JustinPringle/TWLogger/README.md

# TWLogger
## Arduino inertial movement data logger
- Version 2 (IMU)
- Version 3 (IMU+GPS)
