JustinPringle/TWLogger/DataProcessing/Sample_Data/README.md

# TWLogger Sample Data

- Calibration_Data
	- Tag1_LSM303cal.csv - Pre-pocessed Calibration Values (derived from the Raw_data in the accompanying folder)
	- Raw_Calibration_Data - These files can be used to create a Cal file (e.g. Tag1_LSM303cal.csv)
- Raw_Data
	- T1S0708-00.TXT - Deployment details
	- T1D0708-00.CSV, T1D0708-01.CSV - Raw deployment data for use in Data Processing Scripts
