JustinPringle/TWLogger/TWLogger V2/TWLoggerV2.4_LSM9DS0/BuildPhotos/FinalTopView.jpg

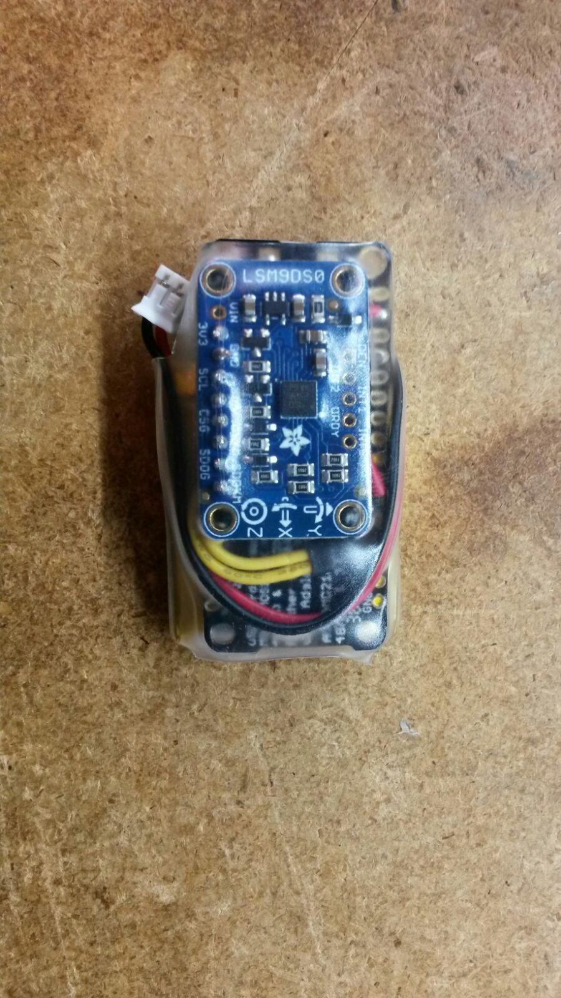
TWLogger V2/TWLoggerV2.4_LSM9DS0/BuildPhotos/FinalTopView.jpg
