JustinPringle/TWLogger/TWLogger V2/TWLoggerV2.4_LSM9DS0/BuildPhotos/IMG-20170116-WA0032.jpg

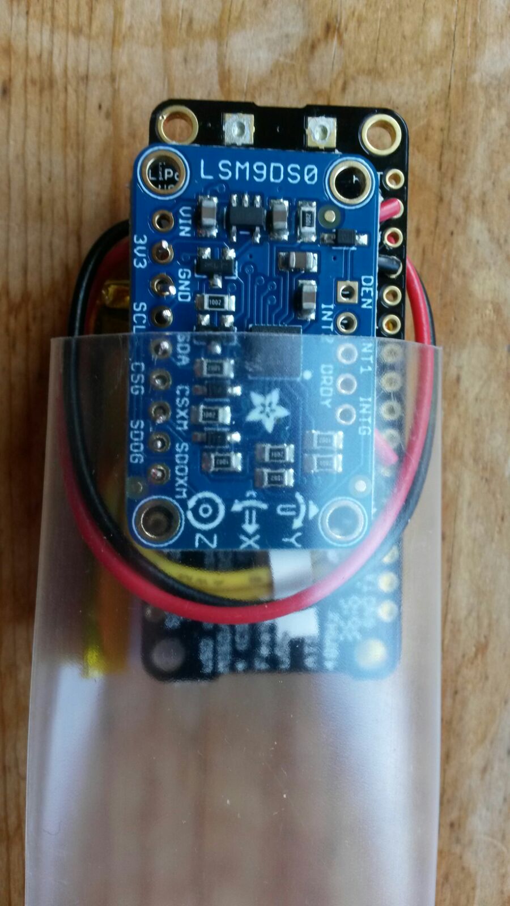
TWLogger V2/TWLoggerV2.4_LSM9DS0/BuildPhotos/IMG-20170116-WA0032.jpg
