JustinPringle/TWLogger/TWLogger V3 (GPS)/TWLogger v3.3_LSM303/TWLoggerV3.3_GPS_LSM303.ino

/*
 Author: James Fahlbusch
 
 Low Power Inertial Movement Datalogger for Feather M0 Adalogger 
 Version 3.3
 Samples Temp, Accel, Mag, and GPS
 Logs to CSV, flushing data after SamplesPerCycle samples
 Internal RTC used to timestamp sensor data
 Utilizes ReTick to Save Power (Sleeps during Idle time)
 Restarts logging if reset (time sync is lost)
 
 RED LED blinks once per minute for a low consumption pulse
 
 Connections (USES I2C and UART)
 Feather M0 to LSm303
 ===========
 Connect Pin 24 (SCL) to SCL
 Connect Pin 23 (SDA) to SDA
 Connect 3V to VIN
 Connect GND to GND
 Feather M0 to UltimateGPS
 ===========
 Connect Pin 12 to En (Enable Pin)
 Connect TX to RX
 Connect RX to TX
 Connect 3V to VIN
 Connect GND to GND
 Connect 3V to VBAT

 Version Notes:
 Added Logfile Timestamps 1/15/17
 Improved Serial Output 1/18/17
 Added clock sync and Sensor Standby 1/21/17
 Changed Acc ODR to 50HZ 1/25/17 
 Implemented ReTick to sleep during unutilized CPU time 1/27/17
 Added Serial Menus and Updated Alarm and Timing 1/29/17
 Added reset timeout for tag restart 11/3/17
 Added GPS functionality 6/4/18 
 Added GPS control Options 6/29/18
 Added Log Chip Serial and samplingRate Options 7/25/18
 Changed Flush and File creation to ensure more regular sampling 8/7/18
 Changed File Naming for 2 digit tag numbers 1/26/19
 Added Plotter Output 1/31/19
 Better GPS Error Checking 8/18/19
 Added functionality to change sensor settings (ODR, scale and gain) 10/8/19
 Added Acceleration and Magnetic field conversion to real units in plotter 4/8/20

 Power Consumption: 
 500mAh Battery - ~39hrs @ 5min GPS, ~32hrs @ 2min GPS, ~26hrs @ 1min (50Hz ACC/Mag)
*/

// ToDo~!!
// *** Add fix delay option (Much like a start delay but determined by gps fix) ***
// Sensitivity testing of variables like timeout, number of samples to collect, MS smart delay
// Retick running at 20ms is actually taking 20.xxx milliseconds, which results in a sample to be missed once every 20 seconds

//////////////// Key Settings /////////////////////////////////
#define vers "Version 3.3"
//#define ECHO_TO_SERIAL       // Allows serial output if uncommented
//#define ECHO_ACC_PLOTTER     // Serial output of just ACC for plotter display (plots in meters/second^2)
//#define ECHO_MAG_PLOTTER     // Serial output of just ACC for plotter display (plots in micro Teslas)
//#define GPSECHO              // Echo the GPS data to the Serial console
//#define Gyro_On              // Allows Gyro output if uncommented
#define MinutesPerCycle 1      // Number of Minutes to buffer before uSD card flush is called. 
#define HoursPerFile 5         // Number of Hours of data per file
#define retickRate 20          // Default sampling rate of 50Hz
#define Serial_Timeout  300000 // Wait time in menu before starting tag (5 min)
// GPS Settings
#define GPS_TIMEOUT         60 // Seconds to wait for a fix to be logged before sleeping
#define GPS_SAMPLING_RATE  120 // Seconds of GPS sleep between data acquisition
#define GPS_DELAY_READ       5 // Seconds to wait before trying to log - allows for a fix
#define LOOP_MAX_VAL         1 // Number of GPS reads before sleeping
#define SMART_DELAY_MS      10 // Number of milliseconds to spend encoding GPS data between other instructions

//////////////// Libraries //////////////////////
#include <RTCZero.h> 
#include <SdFat.h>
SdFat SD;
#include <Wire.h>
#include <SPI.h>
#include <TW_LSM303v2.h>       //library for Accel Mag Sensor LSM 303, updated
#include <TinyGPS.h>
//Libraries for ReTick
#include "Arduino.h"
#include "retick.h"

//////////////// GPS Seentences ///////////////////////////////
// GPS Setup Sentences
#define PMTK_SET_BAUD_9600 "$PMTK251,9600*17"
#define PMTK_SET_BAUD_57600 "$PMTK251,57600*2C"
#define PMTK_SET_NMEA_UPDATE_1HZ  "$PMTK220,1000*1F"
#define PMTK_API_SET_FIX_CTL_1HZ  "$PMTK300,1000,0,0,0,0*1C"
// turn on only the second sentence (GPRMC)
#define PMTK_SET_NMEA_OUTPUT_RMCONLY "$PMTK314,0,1,0,0,0,0,0,0,0,0,0,0,0,0,0,0,0,0,0*29"
// turn on GPRMC and GGA
#define PMTK_SET_NMEA_OUTPUT_RMCGGA "$PMTK314,0,1,0,1,0,0,0,0,0,0,0,0,0,0,0,0,0,0,0*28"
#define PGCMD_NOANTENNA "$PGCMD,33,0*6D" 

/////////////// Global Objects ////////////////////
#define GPSSerial Serial1
TinyGPS GPS;
bool gpsStandby = false;
unsigned int gpscount = 0;
bool endGPSRead = false;
bool logGPS = false; 
long gpsRate = GPS_SAMPLING_RATE; // Seconds of GPS sleep between data acquisition
long gpsTimeOut = GPS_TIMEOUT;    // Seconds to wait for a fix to be logged before sleeping
long gpsDelay = GPS_DELAY_READ;   // Seconds to wait before trying to log - allows for a fix
long loopMaxGPS = LOOP_MAX_VAL;             // Number of GPS reads before sleeping
long smartDelayMS = SMART_DELAY_MS;// Number of milliseconds to spend encoding GPS data between other instructions
unsigned int  loopCounter  = 0;             // Loop counter
unsigned int readCount = 0;
unsigned int hzGPSLog = 0;
char          inByte       = 0;             // Incoming serial byte
String        reading      = "";            // String to hold current reading being created
//Intialize GPS variables
unsigned short sentences = 0, failed = 0;
long lat, lon, altitude;
unsigned long fixage, age, dateUTC, timeUTC, chars = 0;
unsigned long course, speed, sats, hdop;

TW_LSM303v2 lsm = TW_LSM303v2(); // Initialize the IMU
// Default sampling rates
byte AccODR = 0x64;
byte AccRes = 0x08;
byte MagODR = 0x4B;
byte MagRes = 0x04;

#define cardSelect 4  // Set the pin used for uSD
#define RED 13        // Red LED on Pin #13
#define GREEN 8       // Green LED on Pin #8
#define VBATPIN A7    // Battery Voltage on Pin A7
#define gpsEnable 12  // GPS Enable Pin

// re-defines USB serial from M0 chip so it appears as regular serial
#if defined(ARDUINO_SAMD_ZERO) && defined(SERIAL_PORT_USBVIRTUAL)
  // Required for Serial on Zero based boards
  #define Serial SERIAL_PORT_USBVIRTUAL
#endif

char s_month[5];
int tmonth, tday, tyear, thour, tminute, tsecond; 
static const char month_names[] = "JanFebMarAprMayJunJulAugSepOctNovDec"; 

/* Change these values to set the current initial time */
byte hours = 0;
byte minutes = 0;
byte seconds = 0;
/* Change these values to set the current initial date */
byte day = 1;
byte month = 1;
byte year = 17; 
uint32_t tmstmp = 0; // to store Milliseconds (from millis())    
//Used for a time delay, Sets arduino into standby for x minutes
//Could be a local variable instead of global
unsigned short delayStart = 0;
// Variable used to keep track of changes in seconds, minutes, hours, days, months
// Limits the number of calls to RTC
unsigned int timekeeper = 0;
// Variable to store the tag number
uint8_t tag = 0;
uint16_t samplingRate = retickRate; // set sampling rate to default (50Hz)

RTCZero rtc;          // Create RTC object
File logfile;         // Create file object
File settingsFile;    // Create file object
char filename[15];    // Array for file name data logged to named in setup 
char settingsFilename[15];    // Array for file name of Settings File to log settings of Deployment
unsigned int CurrentCycleCount;  // Num of smaples in current cycle, before uSD flush call
unsigned int CurrentFileCount;   // Num of samples in current file
bool start = false;
char tzOffset[] = "+00";    // Array to store Timezone Offset, stored in info file

///////// File Interaction Variables ///////////////////
const uint8_t spiSpeed = SPI_FULL_SPEED; // Use SPI_HALF_SPEED for slower SPI bus speed
// constants for file system structure
uint16_t const BU16 = 128;
uint16_t const BU32 = 8192;
#define sdError(msg) sdError_F(F(msg))
// Serial output stream
ArduinoOutStream cout(Serial);

Sd2Card card;
uint32_t cardSizeBlocks;
uint16_t cardCapacityMB;

// cache for SD block
cache_t cache;

// MBR information
uint8_t partType;
uint32_t relSector;
uint32_t partSize;

// Fake disk geometry
uint8_t numberOfHeads;
uint8_t sectorsPerTrack;

// FAT parameters
uint16_t reservedSectors;
uint8_t sectorsPerCluster;
uint32_t fatStart;
uint32_t fatSize;
uint32_t dataStart;

//  strings needed in file system structures
char noName[] = "NO NAME    ";
char fat16str[] = "FAT16   ";
char fat32str[] = "FAT32   ";
// flash erase all data
uint32_t const ERASE_SIZE = 262144L;


//////////////    Setup   ///////////////////
void setup() {  
  strcpy(filename, "D000101-00.CSV");   // Template for log file name, characters 2 & 3 (Tag#), 8 & 9 (LogFile#) get set automatically later
  strcpy(settingsFilename, "S000101-00.TXT");   // Template for settings file name, characters 2 & 3 (Tag#), 8 & 9  (SettingsFile#) will be used if other deployments are on the same card.
  //enable the GPS
  pinMode(gpsEnable, OUTPUT);
  digitalWrite(gpsEnable, HIGH);

  Serial.begin(115200);
  tmstmp = millis(); //to store a timeout value
  while (!Serial) { // Wait for Serial monitor to open
    if( millis() - tmstmp > Serial_Timeout ) {
       // timed out, restart tag using default values
       start = true;
       tmstmp = 0;
       break;  
    }
  }
  
  //This could be a part of the menu and could give the option to turn it on or leave it off
  GPSSerial.begin(9600); // For Tiny GPS
  GPSSerial.println(PMTK_SET_NMEA_OUTPUT_RMCGGA);
  delay(500);
  GPSSerial.println(PMTK_SET_NMEA_UPDATE_1HZ);
  delay(500);
  GPSSerial.println(PMTK_API_SET_FIX_CTL_1HZ);
  delay(500);

  GPSSerial.println(PMTK_SET_BAUD_57600);
  delay(500);
  GPSSerial.end();
  delay(500);
  GPSSerial.begin(57600);
  delay(500);
  GPSSerial.println(PGCMD_NOANTENNA); 
  delay(500);

  if(!start) {
    // This code sets the clock using serial time.
    // __DATE__ is a C++ preprocessor string with the current date in it.
    // It will look something like 'Mar  13  2016'.
    // So we need to pull those values out and convert the month string to a number.
    sscanf(__DATE__, "%s %d %d", s_month, &tday, &tyear);
    // Similarly, __TIME__ will look something like '09:34:17' so get those numbers.
    sscanf(__TIME__, "%d:%d:%d", &thour, &tminute, &tsecond);
    // Find the position of this month's string inside month_names, do a little
    // pointer subtraction arithmetic to get the offset, and divide the
    // result by 3 since the month names are 3 chars long.
    tmonth = (strstr(month_names, s_month) - month_names) / 3;
    month = tmonth + 1;  // The RTC library expects months to be 1 - 12.
    day = tday;
    year = tyear - 2000; // The RTC library expects years to be from 2000.
    hours = thour;
    minutes = tminute;
    seconds = tsecond;  
    // This is ~30 seconds off due to the time it takes to compile the
    // .ino file and upload the app
  }
  rtc.begin(); // initialize RTC
  rtc.setTime(hours, minutes, seconds);
  rtc.setDate(day, month, year);
  updateFileNames();
  
  /* Initialise the IMU with default settings */
  if(!lsm.begin())
  {
    /* There was a problem detecting the LSM9DS0 ... check your connections */
    Serial.print(F("Ooops, no LSM303 detected ... Check your wiring!"));
    while(1);
  }
  delay(500);

  /* Enter Menu (if serial monitor is open) */  
  while(!start){
    // Print the control menu:
    printMenu();
    // Then wait for any serial data to come in:
    while (!Serial.available());   
    // Once serial data is received, call parseMenu to act on it:
    parseMenu(Serial.read());   
  }

  //Set Alarm
  if(delayStart > 0) {
    
    Serial.println("Logging will begin at:");  
    print2digits(rtc.getAlarmHours());
    Serial.print(":");
    print2digits(rtc.getAlarmMinutes());
    Serial.print(":");
    print2digits(rtc.getAlarmSeconds());
    Serial.print(" on ");
    // Print date...
    print2digits(rtc.getAlarmMonth());
    Serial.print("/");
    print2digits(rtc.getAlarmDay());
    Serial.print("/");
    print2digits(rtc.getAlarmYear());
    Serial.println();
    Serial.println("It is now safe to unplug the unit");
    Serial.end();
    delay(1000);
    rtc.standbyMode();
    rtc.disableAlarm(); 
    rtc.detachInterrupt();
    rtc.updateAlarms();
    delay(5000);
  }
  else {
    Serial.println("Logging will begin immediately"); 
    Serial.println("It is now safe to unplug the unit");
    Serial.end();
  }
  delay(500);
  #ifdef ECHO_TO_SERIAL
    while (! Serial); // Wait until Serial is ready
    Serial.begin(115200);
    Serial.println("\r\nTapered Wings Logger");
  #endif
  #ifdef GPSECHO
    while (! Serial); // Wait until Serial is ready
    Serial.begin(115200);
    Serial.println("\r\nTapered Wings Logger");
  #endif
  delay(500);
  CreateSettingsFile();  
  //start with the current time
  updateTime();
  CreateFile(); 
  reading      = ""; // reset reading
}  

/////////////////////   Loop    //////////////////////
void loop() {
  /*  Each run-through of tick will be samplingRate (default 20ms or 50Hz)
   *  If it takes less than samplingRate, the CPU will sleep
   *  If it takes more, it immediately goes into next 
   *  tick once the previous finishes
   */
  retick(samplingRate);
}

/////////////////////   ReTick    //////////////////////
void tick() {
  WriteToSD();   // Output to uSD card stream, will not actually be written due to buffer/page size  
}

///////////////   Functions   //////////////////

// Create new file on uSD incrementing file name as required
//Purpose of the file is to capture sensor settings, sampling rate, associated log files and battery status
void CreateSettingsFile(void)
{  
  // see if the card is present and can be initialized:
  if (!SD.begin(cardSelect)) {
    #ifdef ECHO_TO_SERIAL
      Serial.println("Card init. failed! or Card not present");
    #endif
    error(2);     // Two red flashes means no card or card init failed.
  }
  //increments the value of the ## in filename (Max is 99)
  for (uint8_t i = 0; i < 100; i++) {
    settingsFilename[8] = '0' + i/10;
    settingsFilename[9] = '0' + i%10;
    // create if does not exist, do not open existing, write, sync after write
    if (! SD.exists(settingsFilename)) {
      break;
    }
  }  

  settingsFile = SD.open(settingsFilename, FILE_WRITE);
  uint16_t C_year = year+2000;
  // set creation date time
  settingsFile.timestamp(T_CREATE, C_year, month, day, hours, minutes, seconds);
  settingsFile.timestamp(T_WRITE, C_year, month, day, hours, minutes, seconds);
  settingsFile.timestamp(T_ACCESS, C_year, month, day, hours, minutes, seconds);
   
  writeDeploymentDetails();
  if( ! settingsFile ) {
   #ifdef ECHO_TO_SERIAL    
    Serial.print("Couldnt create "); 
    Serial.println(settingsFilename); 
   #endif 
    error(3);
  }
  #ifdef ECHO_TO_SERIAL
    Serial.print("Writing to "); 
    Serial.println(settingsFilename);
  #endif
  settingsFile.flush(); //changed from close

}

// Create new file on uSD incrementing file name as required
void CreateFile()
{
  // see if the card is present and can be initialized:
  if (!SD.begin(cardSelect)) {
    #ifdef ECHO_TO_SERIAL
      Serial.println("Card init. failed! or Card not present");
    #endif
    error(2);     // Two red flashes means no card or card init failed.
  }
  //increments the value of the ## in filename (Max is 99)
  for (uint8_t i = 0; i < 100; i++) {
    filename[8] = '0' + i/10;
    filename[9] = '0' + i%10;
    // create if does not exist, do not open existing, write, sync after write
    if (! SD.exists(filename)) {
      break;
    }
  }  
  //log the newly created file name to the settings file
  settingsFile = SD.open(settingsFilename, FILE_WRITE); 
  settingsFile.println(filename); 
  settingsFile.flush();
  //is this necessary
  delay(2); 
  logfile = SD.open(filename, FILE_WRITE);
  // set creation date time
  uint16_t C_year = year+2000;
  logfile.timestamp(T_CREATE, C_year, month, day, hours, minutes, seconds);
  logfile.timestamp(T_WRITE, C_year, month, day, hours, minutes, seconds);
  logfile.timestamp(T_ACCESS, C_year, month, day, hours, minutes, seconds);
  writeHeader();
  if( ! logfile ) {
   #ifdef ECHO_TO_SERIAL    
    Serial.print("Couldnt create "); 
    Serial.println(filename); 
   #endif 
    error(3);
  }
}

// Write data header to file of uSD.
void writeHeader() {
  #ifdef Gyro_On
  logfile.println("Date(MM/DD/YYYY),Time(hh:mm:ss),Timestamp(Ms),Temp(Raw),ACCELX,ACCELY,ACCELZ,MAGX,MAGY,MAGZ,GYRX,GYRY,GYRZ,Sats,HDOP,Latitude,Longitude,FixAge,DateUTC,TimeUTC,DateAge,Altitude,Course,Speed");
  #else
  logfile.println("Date(MM/DD/YYYY),Time(hh:mm:ss),Timestamp(Ms),Temp(Raw),ACCELX,ACCELY,ACCELZ,MAGX,MAGY,MAGZ,Sats,HDOP,Latitude,Longitude,FixAge,DateUTC,TimeUTC,DateAge,Altitude,Course,Speed");
  #endif
}

// Print data and time followed by battery voltage to SD card
void WriteToSD() { 
  timekeeper = rtc.getSeconds(); // Check the time   
  tmstmp = millis();             //Get a time stamp for the data
  if(seconds != timekeeper) {
    gpscount += 1;               //increment the count at 1Hz     
    seconds = timekeeper;
    // NOTE: Temp values are raw and uncalibrated
    // temperature = 21.0 + (float)temperature/8; (21.0 is a guess)
    lsm.readTemp();              //read the temp sensor at 1Hz
    if(seconds == 0){    
      digitalWrite(RED, HIGH);   //pulse once per minute
      minutes = rtc.getMinutes();
      CurrentCycleCount += 1;    //  Increment minute count in current uSD flush cycle
      //  Limit the number of power hungry writes to the uSD
      if( CurrentCycleCount >= MinutesPerCycle ) { 
        logfile.flush(); // this takes about 16 milliseconds and hungrily uses power
        CurrentCycleCount = 0;
      }
      if(minutes == 0){
        hours = rtc.getHours();
        CurrentFileCount += 1;   //  Increment Hour count in current file
        // Limit the number of lines per file
        if( CurrentFileCount >= HoursPerFile ) {
          if (logfile.isOpen()) {
            logfile.close();
          }
          CreateFile();
          //reset both counters
          CurrentFileCount = 0;
          CurrentCycleCount = 0;
          #ifdef ECHO_TO_SERIAL
           Serial.println("New log file created: ");
           Serial.println(filename); 
          #endif
        }
        if(hours == 0){
          day = rtc.getDay();
          if(day == 1){
            month = rtc.getMonth();
            if(month == 1){
              year = rtc.getYear();
            }
          }
        } 
      }
      digitalWrite(RED, LOW);
    }
  }
  /* Read all the sensors. */
  /*   These are Raw values, Calculated values can be obtained by:
   *   event->acceleration.x = accelData.x * _accel_mg_lsb;
   *   event->acceleration.x /= 1000;
   *   event->acceleration.x *= SENSORS_GRAVITY_STANDARD;
   */
  lsm.readAccel();
  #ifdef ECHO_ACC_PLOTTER
    lsm.readAccel_ms2();
  #endif
  /*   These are Raw values, Calculated values can be obtained by:
   *   event->magnetic.x = magData.x * _mag_mgauss_lsb;
   *   event->magnetic.x /= 1000; 
   */
  lsm.readMag();
  #ifdef ECHO_MAG_PLOTTER
    lsm.readMag_mT();
  #endif
  #ifdef Gyro_On  
  /*   These are Raw values, Calculated values can be obtained by:
   *   event->gyro.x = gyroData.x * _gyro_dps_digit;
   */ 
  lsm.readGyro();
  #endif
  
  if(gpsStandby) {  // GPS is most often in standby, so check that first
    if(gpscount>=gpsRate){ // time to wake up  
      #ifdef GPSECHO
        Serial.println("waking up");
      #endif
      digitalWrite(12, HIGH);    // Enable the GPS
      gpsStandby = false;        // GPS is Awake
      gpscount = 0;              // Reset counter
    }
  }else { // GPS is running, so see if it is at timeout or time to log
    if(gpscount >= gpsTimeOut){ 
      #ifdef GPSECHO
        Serial.println("sleeping");
      #endif    
      digitalWrite(12, LOW);     //Disable the GPS
      gpsStandby = true;         // GPS is Asleep
      gpscount = 0;              // reset counter
    }else if(gpscount > gpsDelay){ // wait whole seconds before logging  
      reading = ""; // reset reading
      smartdelay(smartDelayMS); // Do - While Loop to read and encode GPS
      #ifdef GPSECHO 
        GPS.stats(&chars, &sentences, &failed);
        Serial.print("Characters: "); Serial.print(chars); Serial.print(", Sentences: "); Serial.print(sentences); Serial.print(", Failed: "); Serial.println(failed);
      #endif
      GPS.get_position(&lat, &lon, &fixage);  // lat/long in MILLIONTHs of a degree and age of fix in milliseconds    
      sats = GPS.satellites(); //make sure valid satellites before logging 
      // ensure that there are valid satellites (>2, <99), 1 hz logging, a recent position (within 10 Seconds, and lat/lon not zero
      if(sats > 2 && sats < 99 && hzGPSLog != gpscount && fixage < 10000 && lat != 0 && lon != 0){
        logGPS = true; // starts as true, if invalid is found, set to false
        log_int(sats, TinyGPS::GPS_INVALID_SATELLITES, 5);
        log_int(GPS.hdop(), TinyGPS::GPS_INVALID_HDOP, 5);
        log_int(lat, TinyGPS::GPS_INVALID_ANGLE, 10);
        log_int(lon, TinyGPS::GPS_INVALID_ANGLE, 11);
        log_int(fixage, TinyGPS::GPS_INVALID_AGE, 5);
        log_date(GPS);
        log_int(GPS.altitude(), TinyGPS::GPS_INVALID_ALTITUDE, 7);
        log_int(GPS.course(), TinyGPS::GPS_INVALID_ANGLE, 7);
        log_int(GPS.speed(), TinyGPS::GPS_INVALID_SPEED, 6);     
      }
    }
  }
  //RTC Uses DD MM YYYY HH MM SS, so epoch results in extra math
 // Formatting for file output mm/dd/yyyy, hh:mm:ss 
  if(month < 10)
    logfile.print('0'); // add leading zero for formatting
  logfile.print(month);
  logfile.print("/");
  logfile.print(day);
   logfile.print("/20");
  logfile.print(year);
  logfile.print(",");
  if(hours < 10)
    logfile.print('0'); // add leading zero for formatting
  logfile.print(hours);
  logfile.print(":");
  if(minutes < 10)
    logfile.print('0'); // add leading zero for formatting
  logfile.print(minutes);
  logfile.print(":");
  if(seconds < 10)
    logfile.print('0'); // add leading zero for formatting
  logfile.print(seconds); logfile.print(",");
  // sensor timestamp (divide by 1000, remainder is the thousandths of a second)
  logfile.print(tmstmp); logfile.print(",");
  // print Temperature data to the log file:
  logfile.print(lsm.temperature); logfile.print(",");
  // print accelleration data to the log file: 
  logfile.print(lsm.accelData.x); logfile.print(",");
  logfile.print(lsm.accelData.y); logfile.print(",");
  logfile.print(lsm.accelData.z); logfile.print(","); 
  // print magnetometer data to the log file:
  logfile.print(lsm.magData.x); logfile.print(",");
  logfile.print(lsm.magData.y); logfile.print(",");
  #ifdef Gyro_On
    logfile.print(lsm.magData.z); logfile.print(",");
    // print gyroscopic data to the log file:  
    logfile.print(lsm.gyroData.x); logfile.print(",");
    logfile.print(lsm.gyroData.y); logfile.print(",");
    logfile.print(lsm.gyroData.z); 
  #else
    logfile.print(lsm.magData.z); 
  #endif
  // if there is a reading, append it
  if(logGPS){
    logfile.println(reading);
    #ifdef ECHO_TO_SERIAL
      Serial.println(reading);
    #endif
    #ifdef GPSECHO
      Serial.println(reading);
    #endif
    logGPS = false; //reset
    reading = ""; // reset reading
    readCount++;  // increment the count
    if(readCount >= loopMaxGPS){  // Stop logging and put GPS to Sleep     
      gpscount = gpsTimeOut;       // Put the GPS to sleep
      readCount = 0;                // Reset the count of GPS log events
      hzGPSLog = 0;                 // Reset the 1 hz counter
    } else {                        // Continue logging at 1 Hz
      hzGPSLog = gpscount;
    }
    
  }
  // if no reading, move on to next line and compensate commas for no GPS data
  else logfile.println(",,,,,,,,,");

  #ifdef ECHO_TO_SERIAL
    SerialOutput();    // Only logs to serial if ECHO_TO_SERIAL is uncommented at start of code
  #endif
  #ifdef ECHO_ACC_PLOTTER
    PlotterOutput();    // Display Acc in plotter
  #endif
  #ifdef ECHO_MAG_PLOTTER
    PlotterOutput();    // Display Mag in plotter
  #endif  
}


// Debbugging output of time/date and battery voltage
void SerialOutput() {
  if(month < 10)
    Serial.print('0'); // add leading zero for formatting
  Serial.print(month);
  Serial.print("/");
  Serial.print(day);
   Serial.print("/20");
  Serial.print(year);
  Serial.print(" ");
  Serial.print(hours);
  Serial.print(":");
  if(minutes < 10)
    Serial.print('0'); // add leading zero for formatting
  Serial.print(minutes);
  Serial.print(":");
  if(seconds < 10)
    Serial.print('0'); // add leading zero for formatting
  Serial.print(seconds);
  // sensor timestamp (divide by 1000, remainder is the thousandths of a second)
  Serial.print("     "); 
  Serial.println(tmstmp%1000);
  Serial.print("TempRaw: "); Serial.print(lsm.temperature); Serial.print(" ");
  Serial.print("Temp Adjusted: "); Serial.print(21.0 + (float)lsm.temperature/8); Serial.println(" *C");
  Serial.print("AX: "); Serial.print(lsm.accelData.x); Serial.print(" ");
  Serial.print(" AY: "); Serial.print(lsm.accelData.y);       Serial.print(" ");
  Serial.print(" AZ: "); Serial.print(lsm.accelData.z);     Serial.println("  \tRAW Values");
  Serial.print("MX: "); Serial.print(lsm.magData.x); Serial.print(" ");
  Serial.print(" MY: "); Serial.print(lsm.magData.y);       Serial.print(" ");
  Serial.print(" MZ: "); Serial.print(lsm.magData.z);     Serial.println("  \tRAW Values");
  #ifdef Gyro_On
  Serial.print("GX: "); Serial.print(lsm.gyroData.x); Serial.print(" ");
  Serial.print(" GY: "); Serial.print(lsm.gyroData.y);       Serial.print(" ");
  Serial.print(" GZ: "); Serial.print(lsm.gyroData.z);     Serial.println("  \tRAW Values");
  #endif
}

// Very simple display for plotter
void PlotterOutput() {
  #ifdef ECHO_ACC_PLOTTER
    Serial.print(lsm.accelData_ms2.x); Serial.print(" "); Serial.print(lsm.accelData_ms2.y); Serial.print(" "); Serial.print(lsm.accelData_ms2.z); Serial.println();
  #endif
  #ifdef ECHO_MAG_PLOTTER
    Serial.print(lsm.magData_mT.x); Serial.print(" "); Serial.print(lsm.magData_mT.y); Serial.print(" "); Serial.print(lsm.magData_mT.z); Serial.println();
  #endif 
}

//Probably not necessary since noone will see the error blinks
// blink out an error code
void error(uint8_t errno) {
  while(1) {
    uint8_t i;
    for (i=0; i<errno; i++) {
      digitalWrite(13, HIGH);
      delay(100);
      digitalWrite(13, LOW);
      delay(100);
    }
    for (i=errno; i<10; i++) {
      delay(200);
    }
  }
}

/**************************************************************************/
/*
    Displays some basic information on this sensor from the unified
    sensor API sensor_t type (see Adafruit_Sensor for more information)
*/
/**************************************************************************/
void displaySensorDetails(void)
{
  //Display sensor Details such as Sensitivity and Output Data Rate
  Serial.println(F("------------------------------------"));
  Serial.println(F("---- Current IMU Settings ----"));
  Serial.print  (F("Tag Sampling Rate:   ")); Serial.print(1000/samplingRate); Serial.println(F(" Hz"));    
  Serial.print  (F("ACC ODR:             ")); Serial.print(AccODR);   Serial.println(F(" Hz"));
  Serial.print  (F("ACC Resolution:  +/- ")); Serial.print(AccRes); Serial.println(F(" g"));
  Serial.print  (F("MAG ODR:             ")); Serial.print(MagODR); Serial.println(F(" Hz"));
  Serial.print  (F("MAG Resolution:  +/- ")); Serial.print(MagRes); Serial.println(F(" gauss"));
  Serial.println(F("Note: Sensors are set to sample faster (~1.5-2x) than the device sampling rate"));

}

/**************************************************************************/
/*
    Writes to a TXT file pertinent information about the settings of the 
    Deloyment.
*/
/**************************************************************************/
void writeDeploymentDetails(void)
{
  //Start with Date and Time
  settingsFile.println("Tapered Wings Logger");
  settingsFile.println(vers);
  settingsFile.println();
  settingsFile.print("Tag Number: ");
  settingsFile.println(tag);
  // This reads the chip serial number, which is unique to every SAMD21
  volatile uint32_t val1, val2, val3, val4;
  volatile uint32_t *ptr1 = (volatile uint32_t *)0x0080A00C;
  val1 = *ptr1;
  volatile uint32_t *ptr = (volatile uint32_t *)0x0080A040;
  val2 = *ptr; ptr++;
  val3 = *ptr; ptr++;
  val4 = *ptr;
  settingsFile.print("Tag Serial: 0x");
  char buf[33];
  sprintf(buf, "%8x%8x%8x%8x", val1, val2, val3, val4);
  settingsFile.println(buf);
  settingsFile.println();
  settingsFile.print("Initiation Timestamp: ");
  settingsFile.print(month);
  settingsFile.print("/");
  settingsFile.print(day);
  settingsFile.print("/");
  settingsFile.print("20");
  settingsFile.print(year);
  settingsFile.print(" ");
  settingsFile.print(hours);
  settingsFile.print(":");
  if(minutes < 10)
    settingsFile.print('0');      // add leading zero for formatting
  settingsFile.print(minutes);
  settingsFile.print(":");
  if(seconds < 10)
    settingsFile.print('0');      // add leading zero for formatting
  settingsFile.println(seconds);
  settingsFile.print("Timezone Offset: ");
  settingsFile.println(tzOffset);
  settingsFile.println(); 
  //Add sampling Rate
  settingsFile.println(F("----------Key Settings----------"));
  settingsFile.print("Number of Minutes before Flush() is called: "); 
  settingsFile.println(MinutesPerCycle);
  settingsFile.print("Number of Hours of Sampling per CSV file: "); 
  settingsFile.println(HoursPerFile);
  settingsFile.print("IMU Sampling Rate: "); settingsFile.print(1000/samplingRate); settingsFile.println("Hz");
  settingsFile.print("Acc Output Data Rate: "); settingsFile.print(AccODR); settingsFile.println("Hz");
  settingsFile.print("Acc Sensitivity: +/- "); settingsFile.print(AccRes); settingsFile.println("g");
  settingsFile.print("Mag Output Data Rate: "); settingsFile.print(MagODR); settingsFile.println("Hz");
  settingsFile.print("Mag Sensitivity: +/- "); settingsFile.print(MagRes); settingsFile.println("gauss");
  settingsFile.println();
  settingsFile.println(F("GPS Settings:"));
  settingsFile.print("GPS Sampling Rate (seconds): "); settingsFile.println(gpsRate);
  settingsFile.print("GPS Timeout (seconds): "); settingsFile.println(gpsTimeOut);
  settingsFile.print("GPS Read Delay (seconds): "); settingsFile.println(gpsDelay);
  settingsFile.print("GPS Samples per logging interval: "); settingsFile.println(loopMaxGPS);
  settingsFile.print("GPS Smart Delay (milliseconds): "); settingsFile.println(smartDelayMS);
  settingsFile.println();
  settingsFile.println();
  settingsFile.println(F("Associated Log Files:"));

}


/**************************************************************************/
/*
    Configures the gain and integration time for the LSM9DS0
*/
/**************************************************************************/
void configureSensor(void)
{
  /*
  // Change ODR accelerometer continous Now done in LSM9DS0.cpp
  //lsm.write8(XMTYPE, LSM9DS0_REGISTER_CTRL_REG1_XM, 0x57); // 50hz XYZ
  //lsm.write8(XMTYPE, LSM9DS0_REGISTER_CTRL_REG5_XM, 0b01110000); //turns off temp sensor

  // 1.) Set the accelerometer range
  //lsm.setupAccel(lsm.LSM9DS0_ACCELRANGE_2G);
  //lsm.setupAccel(lsm.LSM9DS0_ACCELRANGE_4G);
  //lsm.setupAccel(lsm.LSM9DS0_ACCELRANGE_6G);
  lsm.setupAccel(lsm.LSM9DS0_ACCELRANGE_8G);
  //lsm.setupAccel(lsm.LSM9DS0_ACCELRANGE_16G);
  
  // 2.) Set the magnetometer sensitivity
  lsm.setupMag(lsm.LSM9DS0_MAGGAIN_2GAUSS);
  //lsm.setupMag(lsm.LSM9DS0_MAGGAIN_4GAUSS);
  //lsm.setupMag(lsm.LSM9DS0_MAGGAIN_8GAUSS);
  //lsm.setupMag(lsm.LSM9DS0_MAGGAIN_12GAUSS);

  // 3.) Setup the gyroscope (Degrees per second)
  #ifdef Gyro_On 
  lsm.setupGyro(lsm.LSM9DS0_GYROSCALE_245DPS);
  //lsm.setupGyro(lsm.LSM9DS0_GYROSCALE_500DPS);
  //lsm.setupGyro(lsm.LSM9DS0_GYROSCALE_2000DPS);
  #endif
  */
}

void printMenu()
{
  Serial.println();
  Serial.println();         
  Serial.println(F("////////////////////////////////////////////"));
  Serial.println(F("//       Tapered Wings Logger             //"));
  Serial.println(F("////////////////////////////////////////////"));
  Serial.print("             ");
  Serial.println(vers);
  Serial.print("              ");
  print2digits(rtc.getMonth());
  Serial.print("/");
  print2digits(rtc.getDay());
  Serial.print("/20");
  print2digits(rtc.getYear());
  Serial.println();
  Serial.println();
  Serial.println(F("0) Format Card"));
  Serial.println(F("1) Enter Tag Number"));
  Serial.println(F("2) Set Date and Time (GMT)"));
  Serial.println(F("3) Display Time"));
  Serial.println(F("4) Set Start Delay"));
  Serial.println(F("5) Set IMU Parameters"));
  Serial.println(F("6) Set Local Timezone Offset"));
  Serial.println(F("7) Check GPS Fix"));
  Serial.println(F("8) Set GPS Parameters"));
  Serial.println(F("9) Start Logging"));
  Serial.println(); //could add display tag details and eventually add ability to update ODR
}

void parseMenu(char c)
{
  switch (c)
  {
    case '0':
        sfFormat();      
      break;
    case '1':
        setTagNum();      
      break;
    case '2':
        setRTCTime();      
      break;
    case '3':
        displayRTCTime();   
      break;
    case '4':
        setDelayStart();
      break;
    case '5':
        setIMU();
      break;
    case '6':
        setTZ();
      break;
    case '7':
         getFix();
      break;
    case '8':
         setGPS();
      break;
    case '9':
        //Set Flags to start logging
        start = true;
      break;
  }
}


/**************************************************************************/
/*
    Helper function to prompt for a value, and return
    it if it's within a valid range.
*/
/**************************************************************************/
long prompt(String ask, long mini, long maxi)
{
  Serial.print(ask + "? ");
  while (!Serial.available()) ; // Wait for numbers to come in
  long rsp = Serial.parseInt();
  if ((rsp >= mini) && (rsp <= maxi))
  {
    Serial.println(rsp);
    return rsp;
  }
  else
  {
    Serial.println("Invalid.");
    return 111;
  }
}
/**************************************************************************/
/*
  This function allows the user to sync the time to a GPS
*/
/**************************************************************************/
void updateTime(void)
{
    seconds = rtc.getSeconds();
    minutes = rtc.getMinutes();
    hours = rtc.getHours();
}
/**************************************************************************/
/*
  This function allows the user to Enter a tag Number
  It also sets the Intialization File name
*/
/**************************************************************************/
void setTagNum(void)
{
  bool tagSet = false;
  while(!tagSet){
    Serial.println("Set the Tag Number:");
    byte rsp = prompt("Tag (1-99)", 1, 99);
    if(rsp >= 1 && rsp < 100){ //make  sure it is a valid tag#
      tag = rsp;
      settingsFilename[1] = '0' + tag/10;  //S##0101-00.txt - get the tens digit
      settingsFilename[2] = '0' + tag%10;  //S##0101-00.txt - get the ones digit
      Serial.println(settingsFilename);
      filename[1] = '0' + tag/10; //D0#0101-00.csv - get the tens digit
      filename[2] = '0' + tag%10; //D0#0101-00.csv - get the ones digit
      Serial.println(filename);    
      tagSet = true;
      Serial.println();
      Serial.print("Tag Number: ");
      Serial.println(tag);
      delay(1500);
    }
  }
}

/**************************************************************************/
/*
  This function allows the user to Enter a Timezone offset
  The value is stored in txOffset
*/
/**************************************************************************/
void setTZ(void)
{
  bool tzSet = false;
  while(!tzSet){
    Serial.println("Set the Timezone offset:");
    byte rsp = prompt("Plus or Minus from GMT (Falklands are Minus)? 1 (+), 2 (-)", 1, 2);
    if(rsp >= 1 && rsp < 3){
      if(rsp == 1){
        tzOffset[0] = '+';
      } else {
        tzOffset[0] = '-';
      }
      rsp = prompt("Number of hours? (0-12)", 0, 12);
      if(rsp >= 0 && rsp < 13){
        if(rsp < 10){
          tzOffset[1] = '0';
          tzOffset[2] = '0' + rsp;
        } else{
          tzOffset[1] = '1';
          tzOffset[2] = '0' + rsp%10;
        }    
      }
    tzSet = true;
    Serial.println();
    Serial.print("Timzone Offset: ");
    Serial.print(tzOffset);
    Serial.println();
    delay(1000);
    }
  }
}

/**************************************************************************/
/*
  This function allows the user to set the IMU Parameters
*/
/**************************************************************************/
void setIMU(void)
{
    displaySensorDetails();
    Serial.println(); 
    Serial.println("Which parameters would you like to set?");
    Serial.println(F("0) Return to Main Menu"));
    Serial.println(F("1) IMU Sampling Rate"));
    Serial.println(F("2) Accelerometer Resolution (scale)"));
    Serial.println(F("3) Magnetometer Resolution (gain)"));
    byte rsp = prompt("Enter the number beside the parameter (0-3)", 0, 3);
    switch (rsp)
    {
      case 0:
        break;
      case 1:
        setSamplingRate(); break;
      case 2:
        setAccRes(); break;
      case 3:
        setMagRes(); break;
      default:
        break;
      break;
    }
    displaySensorDetails();
    Serial.println(); 
}


/**************************************************************************/
/*
  This function allows the user to set the Sampling Rate
*/
/**************************************************************************/
void setSamplingRate(void)
{
    Serial.println(); 
    Serial.println("Set the ACC/MAG Sampling Rate:");
    Serial.println(F("1) 1Hz"));
    Serial.println(F("2) 5Hz"));
    Serial.println(F("3) 10Hz"));
    Serial.println(F("4) 25Hz"));
    Serial.println(F("5) 40Hz"));    
    Serial.println(F("6) 50Hz (Default)"));
    //Serial.println(F("7) 100Hz"));// Not implemented in this version
    byte rsp = prompt("Enter the number beside the Sampling Rate (1-6)", 1, 6);
    bool success1 = false;
    bool success2 = false;    
    switch (rsp)
    {
      case 1:
        samplingRate = 1000;
        smartDelayMS = 700; // Expand the GPS listening time 
        success1 = lsm.setAccODR(lsm.LSM303_ACCODR_1HZ);
        success2 = lsm.setMagODR(lsm.LSM303_MAGODR_1_5HZ); 
        if(success1 && success2){ Serial.println("Sampling Rate: 1Hz"); AccODR = 0x01; MagODR = 0x01; } 
        else{ Serial.println("Error writing sampling rate to sensors");} 
        break;
      case 2:
        samplingRate = 200; 
        smartDelayMS = 100; // Expand the GPS listening time 
        success1 = lsm.setAccODR(lsm.LSM303_ACCODR_10HZ);
        success2 = lsm.setMagODR(lsm.LSM303_MAGODR_7_5HZ);         
        if(success1 && success2){ Serial.println("Sampling Rate: 5Hz"); AccODR = 0x0A; MagODR = 0x07;} 
        else{ Serial.println("Error writing sampling rate to sensors"); } 
        break;
      case 3:
        samplingRate = 100; 
        smartDelayMS = 60;
        success1 = lsm.setAccODR(lsm.LSM303_ACCODR_25HZ);
        success2 = lsm.setMagODR(lsm.LSM303_MAGODR_15HZ);         
        if(success1 && success2){ Serial.println("Sampling Rate: 10Hz"); AccODR = 0x19; MagODR = 0x0F;} 
        else{ Serial.println("Error writing sampling rate to sensors"); } 
        break;
      case 4:
        samplingRate = 40; 
        smartDelayMS = 20;
        success1 = lsm.setAccODR(lsm.LSM303_ACCODR_25HZ);
        success2 = lsm.setMagODR(lsm.LSM303_MAGODR_30HZ); 
        if(success1 && success2){ Serial.println("Sampling Rate: 25Hz"); AccODR = 0x19; MagODR = 0x1E;} 
        else{ Serial.println("Error writing sampling rate to sensors");} 
        break;
      case 5:
        samplingRate = 25; 
        smartDelayMS = SMART_DELAY_MS;
        success1 = lsm.setAccODR(lsm.LSM303_ACCODR_50HZ);
        success2 = lsm.setMagODR(lsm.LSM303_MAGODR_75HZ);         
        if(success1 && success2){ Serial.println("Sampling Rate: 40Hz"); AccODR = 0x32; MagODR = 0x4B;} 
        else{ Serial.println("Error writing sampling rate to sensors"); } 
        break;
      case 6:
        samplingRate = 20; 
        smartDelayMS = SMART_DELAY_MS;
        success1 = lsm.setAccODR(lsm.LSM303_ACCODR_100HZ);
        success2 = lsm.setMagODR(lsm.LSM303_MAGODR_75HZ);         
        if(success1 && success2){ Serial.println("Sampling Rate: 50Hz"); AccODR = 0x64; MagODR = 0x4B;} 
        else{ Serial.println("Error writing sampling rate to sensors"); } 
        break;
 /*   case 7: // Not implemented in this version
        samplingRate = 10; 
        smartDelayMS = SMART_DELAY_MS; 
        success1 = lsm.setAccODR(lsm.LSM303_ACCODR_200HZ);
        success2 = lsm.setMagODR(lsm.LSM303_MAGODR_75HZ); 
        if(success1 && success2){ Serial.println("Sampling Rate: 100Hz"); AccODR = 0xC8; MagODR = 0x4B;} 
        else{ Serial.println("Error writing sampling rate to sensors"); } break; */
      default:
        samplingRate = 20;
        smartDelayMS = SMART_DELAY_MS; 
        success1 = lsm.setAccODR(lsm.LSM303_ACCODR_100HZ);
        success2 = lsm.setMagODR(lsm.LSM303_MAGODR_75HZ);         
        if(success1 && success2){ Serial.println("Sampling Rate: 50Hz"); AccODR = 0x64; MagODR = 0x4B;} 
        else{ Serial.println("Error writing sampling rate to sensors"); } 
        break;
      break;
    }
    Serial.println(); 
}

/**************************************************************************/
/*
  This function allows the user to set the ACC Resolution (g)
*/
/**************************************************************************/
void setAccRes(void)
{
    Serial.println(); 
    Serial.println("Set the ACC Resolution (g):");
    Serial.println(F("1) +/- 2G"));
    Serial.println(F("2) +/- 4G"));
    Serial.println(F("3) +/- 8G (Default"));
    Serial.println(F("4) +/- 16G"));
    byte rsp = prompt("Enter the number beside the Resolution value (1-4)", 1, 4);
    bool success = false;
    switch (rsp)
    {
      case 1:
        AccRes = 0x02;
        success = lsm.setAccScale(lsm.LSM303_ACCSCALE_2G); 
        if(success){Serial.println("Acc Resolution: +/- 2g");} else{Serial.println("Error writing Acc Resolution to sensor"); } break;
      case 2:
        AccRes = 0x04;
        success = lsm.setAccScale(lsm.LSM303_ACCSCALE_4G); 
        if(success){Serial.println("Acc Resolution: +/- 4g");} else{Serial.println("Error writing Acc Resolution to sensor"); } break;
      case 3:
        AccRes = 0x08;
        success = lsm.setAccScale(lsm.LSM303_ACCSCALE_8G); 
        if(success){Serial.println("Acc Resolution: +/- 8g");} else{Serial.println("Error writing Acc Resolution to sensor"); } break;    
      case 4:
        AccRes = 0x10;
        success = lsm.setAccScale(lsm.LSM303_ACCSCALE_16G); 
        if(success){Serial.println("Acc Resolution: +/- 16g");} else{Serial.println("Error writing Acc Resolution to sensor"); } break;           
      default:
        AccRes = 0x08;
        success = lsm.setAccScale(lsm.LSM303_ACCSCALE_8G); 
        if(success){Serial.println("Acc Resolution: +/- 8g");} else{Serial.println("Error writing Acc Resolution to sensor"); } break;
    }
    Serial.println(); 
}

/**************************************************************************/
/*
  This function allows the user to set the Magnetometer Gain (gauss)
*/
/**************************************************************************/
void setMagRes(void)
{
    Serial.println();   
    Serial.println("Set the Mag Resolution (gauss):");
    Serial.println(F("1) +/- 1.3 gauss"));
    Serial.println(F("2) +/- 2.5 gauss"));
    Serial.println(F("3) +/- 4.0 gauss (Default"));
    Serial.println(F("4) +/- 8.1 gauss"));
    byte rsp = prompt("Enter the number beside the Resolution value (1-4)", 1, 4);
    bool success = false;
    switch (rsp)
    {
      case 1:
        MagRes = 0x01;
        success = lsm.setMagGain(lsm.LSM303_MAGGAIN_1_3); 
        if(success){Serial.println("Mag Resolution: +/- 1.3 gauss");} else{Serial.println("Error writing Mag Resolution to sensor"); } break;
      case 2:
        MagRes = 0x02;
        success = lsm.setMagGain(lsm.LSM303_MAGGAIN_2_5); 
        if(success){Serial.println("Mag Resolution: +/- 2.5 gauss");} else{Serial.println("Error writing Mag Resolution to sensor"); } break;
      case 3:
        MagRes = 0x04;
        success = lsm.setMagGain(lsm.LSM303_MAGGAIN_4_0); 
        if(success){Serial.println("Mag Resolution: +/- 4 gauss");} else{Serial.println("Error writing Mag Resolution to sensor"); } break;    
      case 4:
        MagRes = 0x08;
        success = lsm.setMagGain(lsm.LSM303_MAGGAIN_8_1); 
        if(success){Serial.println("Mag Resolution: +/- 8.1 gauss");} else{Serial.println("Error writing Mag Resolution to sensor"); } break;           
      default:
        MagRes = 0x04;
        success = lsm.setMagGain(lsm.LSM303_MAGGAIN_4_0); 
        if(success){Serial.println("Mag Resolution: +/- 8g");} else{Serial.println("Error writing Mag Resolution to sensor"); } break;
    }
    Serial.println(); 
}

/**************************************************************************/
/*
  This function allows the user to set the Date
*/
/**************************************************************************/
void setRTCDate(void)
{
    Serial.println("Set the Date (GMT):");
    bool setD = true;
    byte resp = prompt("Year (YY)", 0, 99); // Get the year
    if(resp >= 0 && resp <= 99){ year = resp; }
    else {setD = false;}
    resp = prompt("Month", 1, 12); // Get the month
    if(resp >= 1 && resp <= 12) { month = resp; }
    else {setD = false;}
    resp = prompt("Day", 1, 31); // Get the day
    if(resp >= 1 && resp <= 31) { day = resp; }
    else {setD = false;}
    if(setD){
      rtc.setDate(day, month, year);
      updateFileNames();
    }
    Serial.println("RTC Date set to:");
    print2digits(rtc.getMonth());
    Serial.print("/");
    print2digits(rtc.getDay());
    Serial.print("/20");
    print2digits(rtc.getYear());
    Serial.println();
}

/**************************************************************************/
/*
  This function allows the user to sync the date and time to a GPS
  Should be in GMT
*/
/**************************************************************************/
void setRTCTime(void)
{
  Serial.println("RTC Date");
  print2digits(rtc.getMonth());
  Serial.print("/");
  print2digits(rtc.getDay());
  Serial.print("/20");
  print2digits(rtc.getYear());
  Serial.println();
  Serial.println("Set the Date?");
  byte i2 = prompt("0 = No, 1 = Yes", 0, 1); 
  Serial.println();
  if(i2 != 0){
    setRTCDate();
  } 
  Serial.println(); 
  //Create a loop here to allow user to resync clock
  bool timeSet = false;
  while(!timeSet){
    Serial.println("Set the Tag's Clock. Sync with a GPS");
    Serial.println("Enter a time roughly a minute from now.");
    Serial.println("You will then be prompted to sync at that exact time");    
    hours = prompt("Hour (0-23)", 0, 23); // Get the hour
    minutes = prompt("Minute (0-59)", 0, 59); // Get the minute
    seconds = prompt("Second (0-59)", 0, 59); // Get the second
    Serial.println("Press any key to sync (spacebar, then enter)");
    while (!Serial.available()) ; // Wait for keypress to start clock 
    rtc.begin();    // Start the RTC in 24hr mode
    rtc.setTime(hours, minutes, seconds); // Then set the time
    rtc.setDate(day, month, year); // And the date
    Serial.parseInt();
    Serial.println("Time Set:");
    print2digits(rtc.getHours());
    Serial.print(":");
    print2digits(rtc.getMinutes());
    Serial.print(":");
    print2digits(rtc.getSeconds());
    Serial.println();
    //Add clock display and allow user to reset
    i2 = 0;
    while(i2 < 8){
      timekeeper = rtc.getSeconds();
      if(seconds != timekeeper) {
        seconds = timekeeper;
        Serial.println(seconds);
        i2++;
      }
    }
    Serial.println("Are you happy with the time sync?");
    delay(500); 
    i2 = prompt("0 = No, 1 = Yes", 0, 1);  
    Serial.println();
    if(i2 != 0){
      timeSet = true;
    }  
  }
}

/**************************************************************************/
/*
  This function displays the clock to confirm sync with external source
*/
/**************************************************************************/
void displayRTCTime(void)
{
    Serial.println();
    //Add clock display and allow user to reset
    Serial.println("Press letter key then enter to exit");
    while (!Serial.available()){
      timekeeper = rtc.getSeconds();
      if(seconds != timekeeper) {
        seconds = timekeeper;
        // Print the time
        print2digits(rtc.getHours());
        Serial.print(":");
        print2digits(rtc.getMinutes());
        Serial.print(":");
        print2digits(seconds);
        Serial.println();   
      }
    }
    Serial.parseInt();
    Serial.println();
    Serial.println(); 
}


/**************************************************************************/
/*
 * This function allows the user to set a start delay to the tag
 * Currently only minutes are implemented
*/
/**************************************************************************/
void setDelayStart(void)
{ 
    Serial.println(); 
    Serial.println("Logging Delay Disabled");
    Serial.println(); 
    delay(2000); 
  /* Logging delay does not work with Retick
  Serial.println("Enter a time delay in minutes (must be less than 360):");
  delayStart = prompt("Delay Minutes (0-360)", 0, 360); // Get the delayStart
  if(delayStart > 0) {
    //start with the current time
    updateTime();
    uint8_t delayHrs = hours + (delayStart/60);
    uint8_t delayMin = minutes + (delayStart%60);
    byte delayDAY = day;
    byte delayMON = month;
    byte delayYR = year;
    if (delayMin >= 60){
      delayHrs++;
      delayMin = delayMin%60;
    }
    if (delayHrs >= 24){
      delayHrs = delayHrs%24;
      Serial.println("Please confirm the date the tag will start:");
      print2digits(delayHrs);
      Serial.print(":");
      print2digits(delayMin);
      Serial.println(":00 on"); 
      delayDAY = prompt("Day (DD)", 1, 31); // Get the day
      delayMON = prompt("Month (MM)", 1, 12); // Get the month    
      delayYR = prompt("Year (YY)", 0, 99); // Get the year 
    }
    rtc.setAlarmTime(delayHrs, delayMin, 0);
    rtc.setAlarmDate(delayDAY, delayMON, delayYR); 
    rtc.enableAlarm(rtc.MATCH_YYMMDDHHMMSS); // Once, on a specific date and a specific time
    Serial.println(); 
    Serial.println("Logging will begin at:"); 
    // ...print time
    print2digits(rtc.getAlarmHours());
    Serial.print(":");
    print2digits(rtc.getAlarmMinutes());
    Serial.print(":");
    print2digits(rtc.getAlarmSeconds());
    Serial.print(" on "); 
    // Print date...
    print2digits(rtc.getAlarmMonth());
    Serial.print("/");
    print2digits(rtc.getAlarmDay());
    Serial.print("/");
    print2digits(rtc.getAlarmYear());
    Serial.println();
    Serial.println("You must select Start Logging to initialize the tag.");
    delay(5000);
  }else {
    rtc.disableAlarm();
    Serial.println(); 
    Serial.println("Logging Delay Disabled");
    Serial.println(); 
    delay(5000); 
  }
  */
}


/**************************************************************************/
/*
 * This function allows the user to set GPS sampling parameters
*/
/**************************************************************************/
void setGPS(void)
{ 
    byte i3 = 0;
    Serial.println("Current GPS Settings:");
    Serial.print("GPS Sampling Rate (seconds): "); Serial.println(gpsRate);
    Serial.print("GPS Timeout (seconds): "); Serial.println(gpsTimeOut);
    Serial.print("GPS Read Delay (seconds): "); Serial.println(gpsDelay);
    Serial.print("GPS Samples per logging interval: "); Serial.println(loopMaxGPS);
    Serial.print("GPS Smart Delay (milliseconds): "); Serial.println(smartDelayMS);
    
    Serial.println("Would you like to make changes?");
    delay(500); 
    i3 = prompt("0 = No, 1 = Yes", 0, 1);  
    Serial.println();
    if(i3 != 0){  
      gpsRate = prompt("GPS Sampling Rate(seconds) - default is 120 (min 1, max 3600)", 1, 3600); delay(20);     // Seconds of GPS sleep between data acquisition
      gpsTimeOut = prompt("GPS Timeout(seconds) - default is 60 (min 20, max 90)", 20, 90); delay(20);           // Seconds to wait for a fix to be logged before sleeping
      gpsDelay = prompt("GPS Read Delay(seconds) - default is 5 (min 1, max 30)", 1, 30); delay(20);             // Seconds to wait before trying to log - allows for a fix
      loopMaxGPS = prompt("GPS Samples per logging interval - default is 1 (min 1, max 10)", 1, 10); delay(20);   // Number of GPS reads before sleeping
      //smartDelayMS = prompt("GPS Smart Delay(milliseconds) - default is 10 (min 5, max 500)", 5, 500); delay(20);// Number of milliseconds to spend encoding GPS data between other instructions
    }
}


/**************************************************************************/
/*
  This function displays the GPS Fix status
*/
/**************************************************************************/
static void getFix(void)
{
    float flat, flon;
    unsigned long age, date, time, chars = 0;
    unsigned short sentences = 0, failed = 0;
    static const double PG_LAT = 36.6177, PG_LON = -121.9166;
    Serial.println();
    Serial.println("Press any key then enter to exit");
    delay(1000);
    Serial.println();
    Serial.println("Sats HDOP Latitude  Longitude  Fix  Date       Time     Date Alt    Course Speed Card  Distance Course Card  Chars Sentences Checksum");
    Serial.println("          (deg)     (deg)      Age                      Age  (m)    --- from GPS ----  - to Pacific Grove -  RX    RX        Fail");
    Serial.println("-------------------------------------------------------------------------------------------------------------------------------------");
    
    while (!Serial.available()){
      
      print_int(GPS.satellites(), TinyGPS::GPS_INVALID_SATELLITES, 5);
      print_int(GPS.hdop(), TinyGPS::GPS_INVALID_HDOP, 5);
      GPS.f_get_position(&flat, &flon, &age);
      print_float(flat, TinyGPS::GPS_INVALID_F_ANGLE, 10, 6);
      print_float(flon, TinyGPS::GPS_INVALID_F_ANGLE, 11, 6);
      print_int(age, TinyGPS::GPS_INVALID_AGE, 5);
      print_date(GPS);
      print_float(GPS.f_altitude(), TinyGPS::GPS_INVALID_F_ALTITUDE, 7, 2);
      print_float(GPS.f_course(), TinyGPS::GPS_INVALID_F_ANGLE, 7, 2);
      print_float(GPS.f_speed_kmph(), TinyGPS::GPS_INVALID_F_SPEED, 6, 2);
      print_str(GPS.f_course() == TinyGPS::GPS_INVALID_F_ANGLE ? "*** " : TinyGPS::cardinal(GPS.f_course()), 6);
      print_int(flat == TinyGPS::GPS_INVALID_F_ANGLE ? 0xFFFFFFFF : (unsigned long)TinyGPS::distance_between(flat, flon, PG_LAT, PG_LON) / 1000, 0xFFFFFFFF, 9);
      print_float(flat == TinyGPS::GPS_INVALID_F_ANGLE ? TinyGPS::GPS_INVALID_F_ANGLE : TinyGPS::course_to(flat, flon, PG_LAT, PG_LON), TinyGPS::GPS_INVALID_F_ANGLE, 7, 2);
      print_str(flat == TinyGPS::GPS_INVALID_F_ANGLE ? "*** " : TinyGPS::cardinal(TinyGPS::course_to(flat, flon, PG_LAT, PG_LON)), 6);

      GPS.stats(&chars, &sentences, &failed);
      print_int(chars, 0xFFFFFFFF, 6);
      print_int(sentences, 0xFFFFFFFF, 10);
      print_int(failed, 0xFFFFFFFF, 9);
      Serial.println();
      smartdelay(1000);
      
    }
    Serial.println();
    Serial.println(); 
}

/**************************************************************************/
/*
  This function updates Filenames when a change in Date is made
*/
/**************************************************************************/
void updateFileNames(void){
  // Set MMDD on the init File
  if(month >= 10){
    filename[3] = '0' + month/10;
    filename[4] = '0' + month%10;
    settingsFilename[3] = '0'+ month/10;
    settingsFilename[4] = '0' + month%10; 
  }
  else{
    filename[3] = '0';
    filename[4] = '0' + month;
    settingsFilename[3] = '0';
    settingsFilename[4] = '0' + month; 
  }
  if(day >= 10){
    filename[5] = '0' + day/10;
    filename[6] = '0' + day%10;
    settingsFilename[5] = '0' + day/10;
    settingsFilename[6] = '0' + day%10; 
  }
  else{
    filename[5] = '0';
    filename[6] = '0' + day;
    settingsFilename[5] = '0';
    settingsFilename[6] = '0' + day; 
  }
}


/**************************************************************************/
/*
  This function prints 2-Digit numbers to serial
*/
/**************************************************************************/
static void print2digits(byte number) {
  if (number < 10) {
    Serial.print("0"); // print a 0 before if the number is < than 10
  }
  Serial.print(number);
}

/**************************************************************************/
/*
  This function Feeds the GPS library data to parse
*/
/**************************************************************************/

static void smartdelay(unsigned long ms)
{
  unsigned long start = millis();
  do 
  {
    while (Serial1.available())
      GPS.encode(Serial1.read());
  } while (millis() - start < ms);
}

///////////////////////////////////////////
/////  GPS Print to Serial Functions  /////
static void print_float(float val, float invalid, int len, int prec)
{
  if (val == invalid)
  {
    while (len-- > 1)
      Serial.print('*');
    Serial.print(' ');
  }
  else
  {
    Serial.print(val, prec);
    int vi = abs((int)val);
    int flen = prec + (val < 0.0 ? 2 : 1); // . and -
    flen += vi >= 1000 ? 4 : vi >= 100 ? 3 : vi >= 10 ? 2 : 1;
    for (int i=flen; i<len; ++i)
      Serial.print(' ');
  }
  smartdelay(0);
}

static void print_int(unsigned long val, unsigned long invalid, int len)
{
  char sz[32];
  if (val == invalid)
    strcpy(sz, "*******");
  else
    sprintf(sz, "%ld", val);
  sz[len] = 0;
  for (int i=strlen(sz); i<len; ++i)
    sz[i] = ' ';
  if (len > 0) 
    sz[len-1] = ' ';
  Serial.print(sz);
  smartdelay(0);
}

static void print_date(TinyGPS &gps)
{
  int year;
  byte month, day, hour, minute, second, hundredths;
  unsigned long age;
  GPS.crack_datetime(&year, &month, &day, &hour, &minute, &second, &hundredths, &age);
  if (age == TinyGPS::GPS_INVALID_AGE)
    Serial.print("********** ******** ");
  else
  {
    char sz[32];
    sprintf(sz, "%02d/%02d/%02d %02d:%02d:%02d ",
        month, day, year, hour, minute, second);
    Serial.print(sz);
  }
  print_int(age, TinyGPS::GPS_INVALID_AGE, 5);
  smartdelay(0);
}

static void print_str(const char *str, int len)
{
  int slen = strlen(str);
  for (int i=0; i<len; ++i)
    Serial.print(i<slen ? str[i] : ' ');
  smartdelay(0);
}

//////////////////////////////////////
///// GPS Logging Functions /////////

static void log_int(unsigned long val, unsigned long invalid, int len)
{
  char sz[32];
  if (val == invalid) {
    logGPS = false;
  }
  else {
    sprintf(sz, ",%ld", val);
    reading += sz;
  }
  smartdelay(0);
}

static void log_date(TinyGPS &gps)
{
  int yearGPS;
  byte monthGPS, dayGPS, hourGPS, minuteGPS, secondGPS, hundredthsGPS;
  unsigned long age;
  GPS.crack_datetime(&yearGPS, &monthGPS, &dayGPS, &hourGPS, &minuteGPS, &secondGPS, &hundredthsGPS, &age);  
  // check for 00/00/2000 and a fix within the sampling period
  if (age == TinyGPS::GPS_INVALID_AGE || monthGPS == 0 || age > (gpsRate*1000)) {
    logGPS=false;
  }
  else
  {
    char sz[32];
    sprintf(sz, ",%02d/%02d/%02d,%02d:%02d:%02d,%d",
        monthGPS, dayGPS, yearGPS, hourGPS, minuteGPS, secondGPS, age);
    reading += sz; 
  }

  smartdelay(0);
}
void sfFormat(){
  char c;
//  Serial.begin(9600);
//  // Wait for USB Serial 
//  while (!Serial) {
//    SysCall::yield();
//  }
  cout << F("Type any character to start\n");
  while (!Serial.available()) {
    SysCall::yield();
  }
  // Discard any extra characters.
  do {
    delay(10);
  } while (Serial.available() && Serial.read() >= 0);
  cout << F(
         "\n"
         "This program can erase and/or format SD/SDHC cards.\n"
         "\n"
         "Erase uses the card's fast flash erase command.\n"
         "Flash erase sets all data to 0X00 for most cards\n"
         "and 0XFF for a few vendor's cards.\n"
         "\n"
         "Cards larger than 2 GB will be formatted FAT32 and\n"
         "smaller cards will be formatted FAT16.\n"
         "\n"
         "Warning, all data on the card will be erased.\n"
         "Enter 'Y' to continue: ");
  while (!Serial.available()) {
    SysCall::yield();
  }

  c = Serial.read();
  cout << c << endl;
  if (c != 'Y') {
    cout << F("Quiting, you did not enter 'Y'.\n");
    return;
  }
  // Read any existing Serial data.
  do {
    delay(10);
  } while (Serial.available() && Serial.read() >= 0);

  cout << F(
         "\n"
         "Options are:\n"
         "E - erase the card and skip formatting.\n"
         "F - erase and then format the card. (recommended)\n"
         "Q - quick format the card without erase.\n"
         "\n"
         "Enter option: ");

  while (!Serial.available()) {
    SysCall::yield();
  }
  c = Serial.read();
  cout << c << endl;
  if (!strchr("EFQ", c)) {
    cout << F("Quiting, invalid option entered.") << endl;
    return;
  }

  if (!card.begin(cardSelect, spiSpeed)) {
    cout << F(
           "\nSD initialization failure!\n"
           "Is the SD card inserted correctly?\n"
           "Is chip select correct at the top of this program?\n");
    sdError("card.begin failed");
  }
  cardSizeBlocks = card.cardSize();
  if (cardSizeBlocks == 0) {
    sdError("cardSize");
  }
  cardCapacityMB = (cardSizeBlocks + 2047)/2048;

  cout << F("Card Size: ") << setprecision(0) << 1.048576*cardCapacityMB;
  cout << F(" MB, (MB = 1,000,000 bytes)") << endl;

  if (c == 'E' || c == 'F') {
    eraseCard();
  }
  if (c == 'F' || c == 'Q') {
    formatCard();
  }
  
}

void sdError_F(const __FlashStringHelper* str) {
  cout << F("error: ");
  cout << str << endl;
  if (card.errorCode()) {
    cout << F("SD error: ") << hex << int(card.errorCode());
    cout << ',' << int(card.errorData()) << dec << endl;
  }
  SysCall::halt();
}

// write cached block to the card
uint8_t writeCache(uint32_t lbn) {
  return card.writeBlock(lbn, cache.data);
}
//------------------------------------------------------------------------------
// initialize appropriate sizes for SD capacity
void initSizes() {
  if (cardCapacityMB <= 6) {
    sdError("Card is too small.");
  } else if (cardCapacityMB <= 16) {
    sectorsPerCluster = 2;
  } else if (cardCapacityMB <= 32) {
    sectorsPerCluster = 4;
  } else if (cardCapacityMB <= 64) {
    sectorsPerCluster = 8;
  } else if (cardCapacityMB <= 128) {
    sectorsPerCluster = 16;
  } else if (cardCapacityMB <= 1024) {
    sectorsPerCluster = 32;
  } else if (cardCapacityMB <= 32768) {
    sectorsPerCluster = 64;
  } else {
    // SDXC cards
    sectorsPerCluster = 128;
  }

  cout << F("Blocks/Cluster: ") << int(sectorsPerCluster) << endl;
  // set fake disk geometry
  sectorsPerTrack = cardCapacityMB <= 256 ? 32 : 63;

  if (cardCapacityMB <= 16) {
    numberOfHeads = 2;
  } else if (cardCapacityMB <= 32) {
    numberOfHeads = 4;
  } else if (cardCapacityMB <= 128) {
    numberOfHeads = 8;
  } else if (cardCapacityMB <= 504) {
    numberOfHeads = 16;
  } else if (cardCapacityMB <= 1008) {
    numberOfHeads = 32;
  } else if (cardCapacityMB <= 2016) {
    numberOfHeads = 64;
  } else if (cardCapacityMB <= 4032) {
    numberOfHeads = 128;
  } else {
    numberOfHeads = 255;
  }
}
//------------------------------------------------------------------------------
// zero cache and optionally set the sector signature
void clearCache(uint8_t addSig) {
  memset(&cache, 0, sizeof(cache));
  if (addSig) {
    cache.mbr.mbrSig0 = BOOTSIG0;
    cache.mbr.mbrSig1 = BOOTSIG1;
  }
}
//------------------------------------------------------------------------------
// zero FAT and root dir area on SD
void clearFatDir(uint32_t bgn, uint32_t count) {
  clearCache(false);
  if (!card.writeStart(bgn, count)) {
    sdError("Clear FAT/DIR writeStart failed");
  }
  for (uint32_t i = 0; i < count; i++) {
    if ((i & 0XFF) == 0) {
      cout << '.';
    }
    if (!card.writeData(cache.data)) {
      sdError("Clear FAT/DIR writeData failed");
    }
  }
  if (!card.writeStop()) {
    sdError("Clear FAT/DIR writeStop failed");
  }
  cout << endl;
}
//------------------------------------------------------------------------------
// return cylinder number for a logical block number
uint16_t lbnToCylinder(uint32_t lbn) {
  return lbn / (numberOfHeads * sectorsPerTrack);
}
//------------------------------------------------------------------------------
// return head number for a logical block number
uint8_t lbnToHead(uint32_t lbn) {
  return (lbn % (numberOfHeads * sectorsPerTrack)) / sectorsPerTrack;
}
//------------------------------------------------------------------------------
// return sector number for a logical block number
uint8_t lbnToSector(uint32_t lbn) {
  return (lbn % sectorsPerTrack) + 1;
}
//------------------------------------------------------------------------------
// format and write the Master Boot Record
void writeMbr() {
  clearCache(true);
  part_t* p = cache.mbr.part;
  p->boot = 0;
  uint16_t c = lbnToCylinder(relSector);
  if (c > 1023) {
    sdError("MBR CHS");
  }
  p->beginCylinderHigh = c >> 8;
  p->beginCylinderLow = c & 0XFF;
  p->beginHead = lbnToHead(relSector);
  p->beginSector = lbnToSector(relSector);
  p->type = partType;
  uint32_t endLbn = relSector + partSize - 1;
  c = lbnToCylinder(endLbn);
  if (c <= 1023) {
    p->endCylinderHigh = c >> 8;
    p->endCylinderLow = c & 0XFF;
    p->endHead = lbnToHead(endLbn);
    p->endSector = lbnToSector(endLbn);
  } else {
    // Too big flag, c = 1023, h = 254, s = 63
    p->endCylinderHigh = 3;
    p->endCylinderLow = 255;
    p->endHead = 254;
    p->endSector = 63;
  }
  p->firstSector = relSector;
  p->totalSectors = partSize;
  if (!writeCache(0)) {
    sdError("write MBR");
  }
}
//------------------------------------------------------------------------------
// generate serial number from card size and micros since boot
uint32_t volSerialNumber() {
  return (cardSizeBlocks << 8) + micros();
}
//------------------------------------------------------------------------------
// format the SD as FAT16
void makeFat16() {
  uint32_t nc;
  for (dataStart = 2 * BU16;; dataStart += BU16) {
    nc = (cardSizeBlocks - dataStart)/sectorsPerCluster;
    fatSize = (nc + 2 + 255)/256;
    uint32_t r = BU16 + 1 + 2 * fatSize + 32;
    if (dataStart < r) {
      continue;
    }
    relSector = dataStart - r + BU16;
    break;
  }
  // check valid cluster count for FAT16 volume
  if (nc < 4085 || nc >= 65525) {
    sdError("Bad cluster count");
  }
  reservedSectors = 1;
  fatStart = relSector + reservedSectors;
  partSize = nc * sectorsPerCluster + 2 * fatSize + reservedSectors + 32;
  if (partSize < 32680) {
    partType = 0X01;
  } else if (partSize < 65536) {
    partType = 0X04;
  } else {
    partType = 0X06;
  }
  // write MBR
  writeMbr();
  clearCache(true);
  fat_boot_t* pb = &cache.fbs;
  pb->jump[0] = 0XEB;
  pb->jump[1] = 0X00;
  pb->jump[2] = 0X90;
  for (uint8_t i = 0; i < sizeof(pb->oemId); i++) {
    pb->oemId[i] = ' ';
  }
  pb->bytesPerSector = 512;
  pb->sectorsPerCluster = sectorsPerCluster;
  pb->reservedSectorCount = reservedSectors;
  pb->fatCount = 2;
  pb->rootDirEntryCount = 512;
  pb->mediaType = 0XF8;
  pb->sectorsPerFat16 = fatSize;
  pb->sectorsPerTrack = sectorsPerTrack;
  pb->headCount = numberOfHeads;
  pb->hidddenSectors = relSector;
  pb->totalSectors32 = partSize;
  pb->driveNumber = 0X80;
  pb->bootSignature = EXTENDED_BOOT_SIG;
  pb->volumeSerialNumber = volSerialNumber();
  memcpy(pb->volumeLabel, noName, sizeof(pb->volumeLabel));
  memcpy(pb->fileSystemType, fat16str, sizeof(pb->fileSystemType));
  // write partition boot sector
  if (!writeCache(relSector)) {
    sdError("FAT16 write PBS failed");
  }
  // clear FAT and root directory
  clearFatDir(fatStart, dataStart - fatStart);
  clearCache(false);
  cache.fat16[0] = 0XFFF8;
  cache.fat16[1] = 0XFFFF;
  // write first block of FAT and backup for reserved clusters
  if (!writeCache(fatStart)
      || !writeCache(fatStart + fatSize)) {
    sdError("FAT16 reserve failed");
  }
}
//------------------------------------------------------------------------------
// format the SD as FAT32
void makeFat32() {
  uint32_t nc;
  relSector = BU32;
  for (dataStart = 2 * BU32;; dataStart += BU32) {
    nc = (cardSizeBlocks - dataStart)/sectorsPerCluster;
    fatSize = (nc + 2 + 127)/128;
    uint32_t r = relSector + 9 + 2 * fatSize;
    if (dataStart >= r) {
      break;
    }
  }
  // error if too few clusters in FAT32 volume
  if (nc < 65525) {
    sdError("Bad cluster count");
  }
  reservedSectors = dataStart - relSector - 2 * fatSize;
  fatStart = relSector + reservedSectors;
  partSize = nc * sectorsPerCluster + dataStart - relSector;
  // type depends on address of end sector
  // max CHS has lbn = 16450560 = 1024*255*63
  if ((relSector + partSize) <= 16450560) {
    // FAT32
    partType = 0X0B;
  } else {
    // FAT32 with INT 13
    partType = 0X0C;
  }
  writeMbr();
  clearCache(true);

  fat32_boot_t* pb = &cache.fbs32;
  pb->jump[0] = 0XEB;
  pb->jump[1] = 0X00;
  pb->jump[2] = 0X90;
  for (uint8_t i = 0; i < sizeof(pb->oemId); i++) {
    pb->oemId[i] = ' ';
  }
  pb->bytesPerSector = 512;
  pb->sectorsPerCluster = sectorsPerCluster;
  pb->reservedSectorCount = reservedSectors;
  pb->fatCount = 2;
  pb->mediaType = 0XF8;
  pb->sectorsPerTrack = sectorsPerTrack;
  pb->headCount = numberOfHeads;
  pb->hidddenSectors = relSector;
  pb->totalSectors32 = partSize;
  pb->sectorsPerFat32 = fatSize;
  pb->fat32RootCluster = 2;
  pb->fat32FSInfo = 1;
  pb->fat32BackBootBlock = 6;
  pb->driveNumber = 0X80;
  pb->bootSignature = EXTENDED_BOOT_SIG;
  pb->volumeSerialNumber = volSerialNumber();
  memcpy(pb->volumeLabel, noName, sizeof(pb->volumeLabel));
  memcpy(pb->fileSystemType, fat32str, sizeof(pb->fileSystemType));
  // write partition boot sector and backup
  if (!writeCache(relSector)
      || !writeCache(relSector + 6)) {
    sdError("FAT32 write PBS failed");
  }
  clearCache(true);
  // write extra boot area and backup
  if (!writeCache(relSector + 2)
      || !writeCache(relSector + 8)) {
    sdError("FAT32 PBS ext failed");
  }
  fat32_fsinfo_t* pf = &cache.fsinfo;
  pf->leadSignature = FSINFO_LEAD_SIG;
  pf->structSignature = FSINFO_STRUCT_SIG;
  pf->freeCount = 0XFFFFFFFF;
  pf->nextFree = 0XFFFFFFFF;
  // write FSINFO sector and backup
  if (!writeCache(relSector + 1)
      || !writeCache(relSector + 7)) {
    sdError("FAT32 FSINFO failed");
  }
  clearFatDir(fatStart, 2 * fatSize + sectorsPerCluster);
  clearCache(false);
  cache.fat32[0] = 0x0FFFFFF8;
  cache.fat32[1] = 0x0FFFFFFF;
  cache.fat32[2] = 0x0FFFFFFF;
  // write first block of FAT and backup for reserved clusters
  if (!writeCache(fatStart)
      || !writeCache(fatStart + fatSize)) {
    sdError("FAT32 reserve failed");
  }
}
//------------------------------------------------------------------------------
// flash erase all data
void eraseCard() {
  cout << endl << F("Erasing\n");
  uint32_t firstBlock = 0;
  uint32_t lastBlock;
  uint16_t n = 0;

  do {
    lastBlock = firstBlock + ERASE_SIZE - 1;
    if (lastBlock >= cardSizeBlocks) {
      lastBlock = cardSizeBlocks - 1;
    }
    if (!card.erase(firstBlock, lastBlock)) {
      sdError("erase failed");
    }
    cout << '.';
    if ((n++)%32 == 31) {
      cout << endl;
    }
    firstBlock += ERASE_SIZE;
  } while (firstBlock < cardSizeBlocks);
  cout << endl;

  if (!card.readBlock(0, cache.data)) {
    sdError("readBlock");
  }
  cout << hex << showbase << setfill('0') << internal;
  cout << F("All data set to ") << setw(4) << int(cache.data[0]) << endl;
  cout << dec << noshowbase << setfill(' ') << right;
  cout << F("Erase done\n");
}
//------------------------------------------------------------------------------
void formatCard() {
  cout << endl;
  cout << F("Formatting\n");
  initSizes();
  if (card.type() != SD_CARD_TYPE_SDHC) {
    cout << F("FAT16\n");
    makeFat16();
  } else {
    cout << F("FAT32\n");
    makeFat32();
  }
#if DEBUG_PRINT
  debugPrint();
#endif  // DEBUG_PRINT
  cout << F("Format done\n");
}
