JustinPringle/TWLogger/(commit log)

2018-08-08 Update and rename SensorLoggerV2.4_LSM303/Readme to TWLogger Version 2 -No GPS/Readme
2018-08-08 Rename SensorLoggerV2.4_LSM303/SensorLoggerV2.4_LSM303.ino to TWLogger Version 2 - No GPS/TWLoggerV2.4_LSM303.ino
2018-08-08 Rename SensorLoggerV2.4_LSM303/libraries/New to TWLogger Version 2 - No GPS/TWLoggerV2.4_LSM303/libraries/New
2019-08-07 Build Instructions & Circuitry Diagram
2019-08-22 Version 3.2.3
    Added better on-board GPS error checking to reduce the incidence of bad GPS hits
    [TWLoggerV3.2.3_GPS_LSM303.ino]
2019-10-10 Update to Version 3.3
    Major revision of TWLogger script as well as the TW_LSM303 library. Added the ability to adjust IMU parameters from the user interface.
2019-11-03 Adding Sample Data
    These files are to allow a user to utilize the data processing scripts without collecting additional data.
    [T1D0711-00.CSV]
2019-11-12 Added Readme
    [T1D0711-00.CSV, Tag1_LSM303cal.csv]
